ollixx77/rauch/pcb/STM32_Rauch changes.txt

circuitName   : STM32_Rauch
author        : Oliver Schumann
--------------------------------------------------------------------------------
  _ _ _   _____     ____          _ _ _ 
 | | | | |_   _|__ |  _ \  ___   | | | | ToDo
 | | | |   | |/ _ \| | | |/ _ \  | | | |
 |_|_|_|   | | (_) | |_| | (_) | |_|_|_|
 (_|_|_)   |_|\___/|____/ \___/  (_|_|_)

- ...

  _ _ _    ____ _                                   _ _ _ 
 | | | |  / ___| |__   __ _ _ __   __ _  ___  ___  | | | | Changes
 | | | | | |   | '_ \ / _` | '_ \ / _` |/ _ \/ __| | | | |
 |_|_|_| | |___| | | | (_| | | | | (_| |  __/\__ \ |_|_|_|
 (_|_|_)  \____|_| |_|\__,_|_| |_|\__, |\___||___/ (_|_|_)
                                  |___/                   

23.04.2026, STM32_Rauch_002:
Ä Relais mirrored
Ä Push button 		!RST	-> PA6
Ä TM1637 holes		2 mm	-> 3.2 mm

KW11.2026, STM32_Rauch_001:
