ollixx77/rauch/pcb/A5E52699480_001.xlsx

Bestückhilfe für Eagle |  |  |  |  |  | 1. Stückliste in Tabelle (Spalten B..G) einfügen, die Spalte "Parts" ist die wichtige
Stand | 2023-03-30 |  |  |  |  | 2. Jeweils Einträge in "C&P" kopieren und im Eagle-Layout in Befehlszeile einfügen <Enter>
 |  |  |  |  |  | 3. In Spalte "Kommentar" den Status eintragen, ok = bestückt, Probleme ect.
Qty | Value | Device | Package | Parts | Description | .. | ..2 | C&P | Kommentar
2 | 0R | R-EU_2010 | RESC2010 | R6, R9 | RESISTOR, European symbol |  |  | show @ R6 R9
2 | 0R | R-EU_0603 | RESC0603 | R12, R14 | RESISTOR, European symbol |  |  | show @ R12 R14 | ok
2 | 100R | R-EU_0603 | RESC0603 | R24, R33 | RESISTOR, European symbol |  |  | show @ R24 R33 | ok
4 | 100n | C-EU0603 | CAPC0603 | C1, C6, C8, C9 | CAPACITOR, European symbol |  |  | show @ C1 C6 C8 C9 | ok
4 | 10R | R-EU_0603 | RESC0603 | R5, R8, R11, R16 | RESISTOR, European symbol |  |  | show @ R5 R8 R11 R16 | ok
1 | 10µ/4A - IHLP2525CZER100M11 | L-EU0707 | INDM0707 | L1 | INDUCTOR, European symbol |  |  | show @ L1 | ok
1 | 150p | C-EU0603 | CAPC0603 | C7 | CAPACITOR, European symbol |  |  | show @ C7 | ok
1 | 18R | R-EU_0603 | RESC0603 | R30 | RESISTOR, European symbol |  |  | show @ R30 | ok, 25R
1 | 1M | R-EU_0603 | RESC0603 | R2 | RESISTOR, European symbol |  |  | show @ R2 | ok
6 | 1k | R-EU_0603 | RESC0603 | R4, R7, R10, R15, R22, R25 | RESISTOR, European symbol |  |  | show @ R4 R7 R10 R15 R22 R25 | ok
2 | 2,2k | R-EU_0603 | RESC0603 | R23, R32 | RESISTOR, European symbol |  |  | show @ R23 R32 | ok
1 | 22k | R-EU_0603 | RESC0603 | R1 | RESISTOR, European symbol |  |  | show @ R1 | ok
2 | 22µ/6,3V | C-EU1206 | CAPC1206 | C3, C4 | CAPACITOR, European symbol |  |  | show @ C3 C4 | ok
1 | 2k | R-EU_0603 | RESC0603 | R27 | RESISTOR, European symbol |  |  | show @ R27 | ok
6 | 33 | RRWM10X45 | RWM10X45 | R101, R102, R103, R201, R202, R203 | Power Resitor |  |  | show @ R101 R102 R103 R201 R202 R203 | FE
1 | 330p | C-EU0603 | CAPC0603 | C5 | CAPACITOR, European symbol |  |  | show @ C5 | ok, 470p
1 | 33R | R-EU_0603 | RESC0603 | R26 | RESISTOR, European symbol |  |  | show @ R26 | ok
1 | 4,7k | R-EU_0603 | RESC0603 | R3 | RESISTOR, European symbol |  |  | show @ R3 | ok
1 | 4,7µ/50V | C-EU1210 | CAPC1210 | C2 | CAPACITOR, European symbol |  |  | show @ C2 | ok
3 | 470R | R-EU_0603 | RESC0603 | R17, R18, R19 | RESISTOR, European symbol |  |  | show @ R17 R18 R19 | ok
4 | 47k | R-EU_0603 | RESC0603 | R21, R28, R34, R35 | RESISTOR, European symbol |  |  | show @ R21 R28 R34 R35 | ok
1 | 560R | R-EU_0603 | RESC0603 | R31 | RESISTOR, European symbol |  |  | show @ R31 | ok
1 | 680R | R-EU_0603 | RESC0603 | R29 | RESISTOR, European symbol |  |  | show @ R29 | ok
6 | 68n/2kV | C-EU275-205X316 | C275-205X316 | C101, C102, C103, C201, C202, C203 | CAPACITOR, European symbol |  |  | show @ C101 C102 C103 C201 C202 C203 | FE
1 | A5E52699480/RS-AA/001 | TEXT-50-TOP | DOKU-50-TOP | DOKU5 | Textfeld für Dokumentation |  |  | show @ DOKU5 | n.b.
1 | A5E________/RS-AA/001 | TEXT-30-DUMMY | DOKU-30-DUMMY | DOKU6 | Textfeld für Dokumentation |  |  | show @ DOKU6 | n.b.
1 | BAS40-05 | BAT54C | SOT23 | D5 | Dioden mit gemeinsamer Kathode |  |  | show @ D5 | ok
1 | BCX56-16 | TRANSISTOR-NPN-SOT23 | SOT23 | Q1 |  |  |  | show @ Q1 | ok, BCX-41
3 | DIODE-LED-C1608 | DIODE-LED-C1608 | LEDC1608 | D2, D3, D4 |  |  |  | show @ D2 D3 D4 | ok
1 | HEADER-M-2X05-RM254 | HEADER-M-2X05-RM254 | CON-HEADER-M-RM254-2X05 | X4 |  |  |  | show @ X4
1 | HEADER-M-2X14-RM254 | HEADER-M-2X14-RM254 | CON-HEADER-M-RM254-2X14 | X3 |  |  |  | show @ X3
1 | LM2903D | LM2903D | SOP127P600-08 | IC3 | COMPARATOR |  |  | show @ IC3 | ok, LM358
1 | LMR51430YFDDCR | LMR51430 | SOT23-6 | IC1 | LMR51430 SIMPLE SWITCHER® 4.5-V to 36-V, 3-A, Synchronous Buck Converter in a SOT-23 Package |  |  | show @ IC1 | ok
1 | MC1,5/10-G-3,81 | MC1,5/10-G-3,81 | MC1,5/10-G-3,81 | X2 | Phoenix Contact |  |  | show @ X2
4 | MOUNT-HOLE-3.2 | MOUNT-HOLE-3.2 | MOUNT-HOLE-3,2 | H1, H2, H3, H4 | Mounting Hole |  |  | show @ H1 H2 H3 H4 | ok
10 | MOUNT-PAD-ROUND1.0 | MOUNT-PAD-ROUND1.0 | 1,0-PAD | H101, H102, H103, H104, H105, H201, H202, H203, H204, H205 | MOUNTING PAD, round |  |  | show @ H101 H102 H103 H104 H105 H201 H202 H203 H204 H205 | FE
1 | MSTBVA2,5/4-G-5,08 - 1755752 | MSTBVA2,5/4-G-5,08 | MSTBVA2,5/4-G-5,08 | X1 | Phoenix Contact |  |  | show @ X1 | ok
2 | PAD-FIDU-R200 | PAD-FIDU-R200 | FIDU_RUND-2MM | DOKU1, DOKU2 | Fiducial = Passermarke |  |  | show @ DOKU1 DOKU2 | n.b.
4 | SKS01VKR | SKS01VKR | SKS01VKR | XX1, XX2, XX3, XX4 | ST50MVNR & SR50MVNR |  |  | show @ XX1 XX2 XX3 XX4
1 | SS16 | DIODE-SCHOTTKY-SMA | DIOM-SMA | D1 |  |  |  | show @ D1 | ok
1 | STM NUCLEO-G031K8 | STM32-NUCLEO32 | NUCLEO32 | M1 | Arduino Nano plug in module with SMT32 Nucleo-32 signal names |  |  | show @ M1 | n.b.
1 | STM32_oC_test_001 | TEXT-50-TOP | DOKU-50-TOP | DOKU3 | Textfeld für Dokumentation |  |  | show @ DOKU3 | n.b.
1 | TL431DBZ | TL431DBZ | SOT23 | IC2 | TL431 Precision Programmable Reference |  |  | show @ IC2 | ok
1 | close | CON-J2D | CON-SOLDERJUMPER | J1 | Jumper 2pol. |  |  | show @ J1 | ok
