ollixx77/rauch/pcb/STM32_Rauch_001.xlsx

Bestückhilfe für Eagle |  |  |  |  |  | 1. Stückliste in Tabelle (Spalten B..G) einfügen, die Spalte "Parts" ist die wichtige
Stand | 2026-03-30 |  |  |  |  | 2. Jeweils Einträge in "C&P" kopieren und im Eagle-Layout in Befehlszeile einfügen <Enter>
 |  |  |  |  |  | 3. In Spalte "Kommentar" den Status eintragen, ok = bestückt, Probleme ect.
Qty | Value | Device | Package | Parts | Description | .. | ..2 | C&P | Kommentar
11 | 100n | C-EU0603 | CAPC0603 | C2, C5, C6, C7, C8, C9, C10, C11, C12, C13, C14 | CAPACITOR, European symbol |  |  | show @ C2 C5 C6 C7 C8 C9 C10 C11 C12 C13 C14 | x
2 | 22µ/6,3V | C-EU1206 | CAPC1206 | C3, C4 | CAPACITOR, European symbol |  |  | show @ C3 C4 | x
1 | 4,7µ/50V | C-EU1210 | CAPC1210 | C1 | CAPACITOR, European symbol |  |  | show @ C1 | x
1 | open | CON-J2D | CON-SOLDERJUMPER | J1 | Jumper 2pol. |  |  | show @ J1 | n.b.
11 | LED gelb | DIODE-LED-C1608 | LEDC1608 | D4, D7, D8, D9, D10, D11, D12, D13, D14, D15, D16 |  |  |  | show @ D4 D7 D8 D9 D10 D11 D12 D13 D14 D15 D16 | x
1 | LED grün | DIODE-LED-C1608 | LEDC1608 | D6 |  |  |  | show @ D6 | x
1 | LED rot | DIODE-LED-C1608 | LEDC1608 | D5 |  |  |  | show @ D5 | x
1 | SS16 | DIODE-SCHOTTKY-SMA | DIOM-SMA | D1 |  |  |  | show @ D1 | x
1 | 1N4448 | DIODE-SOD323 | SOD323 | D3 |  |  |  | show @ D3 | x
1 | SM15T39A | DIODE-TVS-UNI-SMC | DIOM-SMC | D2 |  |  |  | show @ D2 | x
1 | 10µ/4A - IHLP2525CZER100M11 | L-EU0707 | INDM0707 | L1 | INDUCTOR, European symbol |  |  | show @ L1 | x
1 | LMR51430YFDDCR | LMR51430 | SOT23-6 | IC1 | LMR51430 SIMPLE SWITCHER® 4.5-V to 36-V, 3-A, Synchronous Buck Converter in a SOT-23 Package |  |  | show @ IC1 | x
1 | MCV1,5/10-G-3,81 | MCV1,5/10-G-3,81 | MCV1,5/10-G-3,81 | X4 | Phoenix Contact |  |  | show @ X4 | x
1 | MCV1,5/4-G-3,81 | MCV1,5/4-G-3,81 | MCV1,5/4-G-3,81 | X3 | Phoenix Contact |  |  | show @ X3 | x
1 | MOLEX-6410/4 | MOLEX-6410/4 | MOLEX-6410/4 | X5 | Molex Serie 6410 |  |  | show @ X5 | falsches Raster
4 | MOUNT-HOLE-3.2 | MOUNT-HOLE-3.2 | MOUNT-HOLE-3,2 | H1, H2, H3, H4 | Mounting Hole |  |  | show @ H1 H2 H3 H4 | zu klein
1 | MSTBVA2,5/3-G-5,08 | MSTBVA2,5/3-G-5,08 | MSTBVA2,5/3-G-5,08 | X2 | Phoenix Contact |  |  | show @ X2 | x
1 | MSTBVA2,5/4-G-5,08 - 1755752 | MSTBVA2,5/4-G-5,08 | MSTBVA2,5/4-G-5,08 | X1 | Phoenix Contact |  |  | show @ X1 | x
1 | G5Q-14-EU DC12 (TY) | RELAIS1-OMRON-G5Q | OMRON-G5Q | K1 |  |  |  | show @ K1 | falsch herum
10 | 10K | R-EU_0603 | RESC0603 | R11, R12, R13, R14, R15, R26, R27, R28, R29, R30 | RESISTOR, European symbol |  |  | show @ R11 R12 R13 R14 R15 R26 R27 R28 R29 R30 | x
1 | 1k | R-EU_0603 | RESC0603 | R7 | RESISTOR, European symbol |  |  | show @ R7 | x
1 | 1M | R-EU_0603 | RESC0603 | R2 | RESISTOR, European symbol |  |  | show @ R2 | x
1 | 36k | R-EU_0603 | RESC0603 | R1 | RESISTOR, European symbol |  |  | show @ R1 | x
1 | 4,7k | R-EU_0603 | RESC0603 | R3 | RESISTOR, European symbol |  |  | show @ R3 | x
10 | 4.7k | R-EU_0603 | RESC0603 | R31, R32, R33, R34, R35, R36, R37, R38, R39, R40 | RESISTOR, European symbol |  |  | show @ R31 R32 R33 R34 R35 R36 R37 R38 R39 R40 | x
4 | 470R | R-EU_0603 | RESC0603 | R4, R8, R9, R10 | RESISTOR, European symbol |  |  | show @ R4 R8 R9 R10 | x
10 | 68k | R-EU_0603 | RESC0603 | R16, R17, R18, R19, R20, R21, R22, R23, R24, R25 | RESISTOR, European symbol |  |  | show @ R16 R17 R18 R19 R20 R21 R22 R23 R24 R25 | x
2 | n.b. | R-EU_0603 | RESC0603 | R5, R6 | RESISTOR, European symbol |  |  | show @ R5 R6 | n.b.
1 | SCHURTER_LSH | SCHURTER_LSH | SHURTER_LSH | S1 |  |  |  | show @ S1 | x
1 | STM NUCLEO-G031K8 | STM32-NUCLEO32 | NUCLEO32 | M1 | Arduino Nano plug in module with SMT32 Nucleo-32 signal names |  |  | show @ M1 | x
1 | TM1637 | TM1637 | TM1637 | DIS1 | TM1637 |  |  | show @ DIS1 | redesign
11 | BC547 | TRANSISTOR-NPN-SOT23 | SOT23 | Q1, Q2, Q3, Q4, Q5, Q6, Q7, Q8, Q9, Q10, Q11 |  |  |  | show @ Q1 Q2 Q3 Q4 Q5 Q6 Q7 Q8 Q9 Q10 Q11 | BC847B
