ollixx77/rauch/pcb/STM32_Rauch_002.pdf

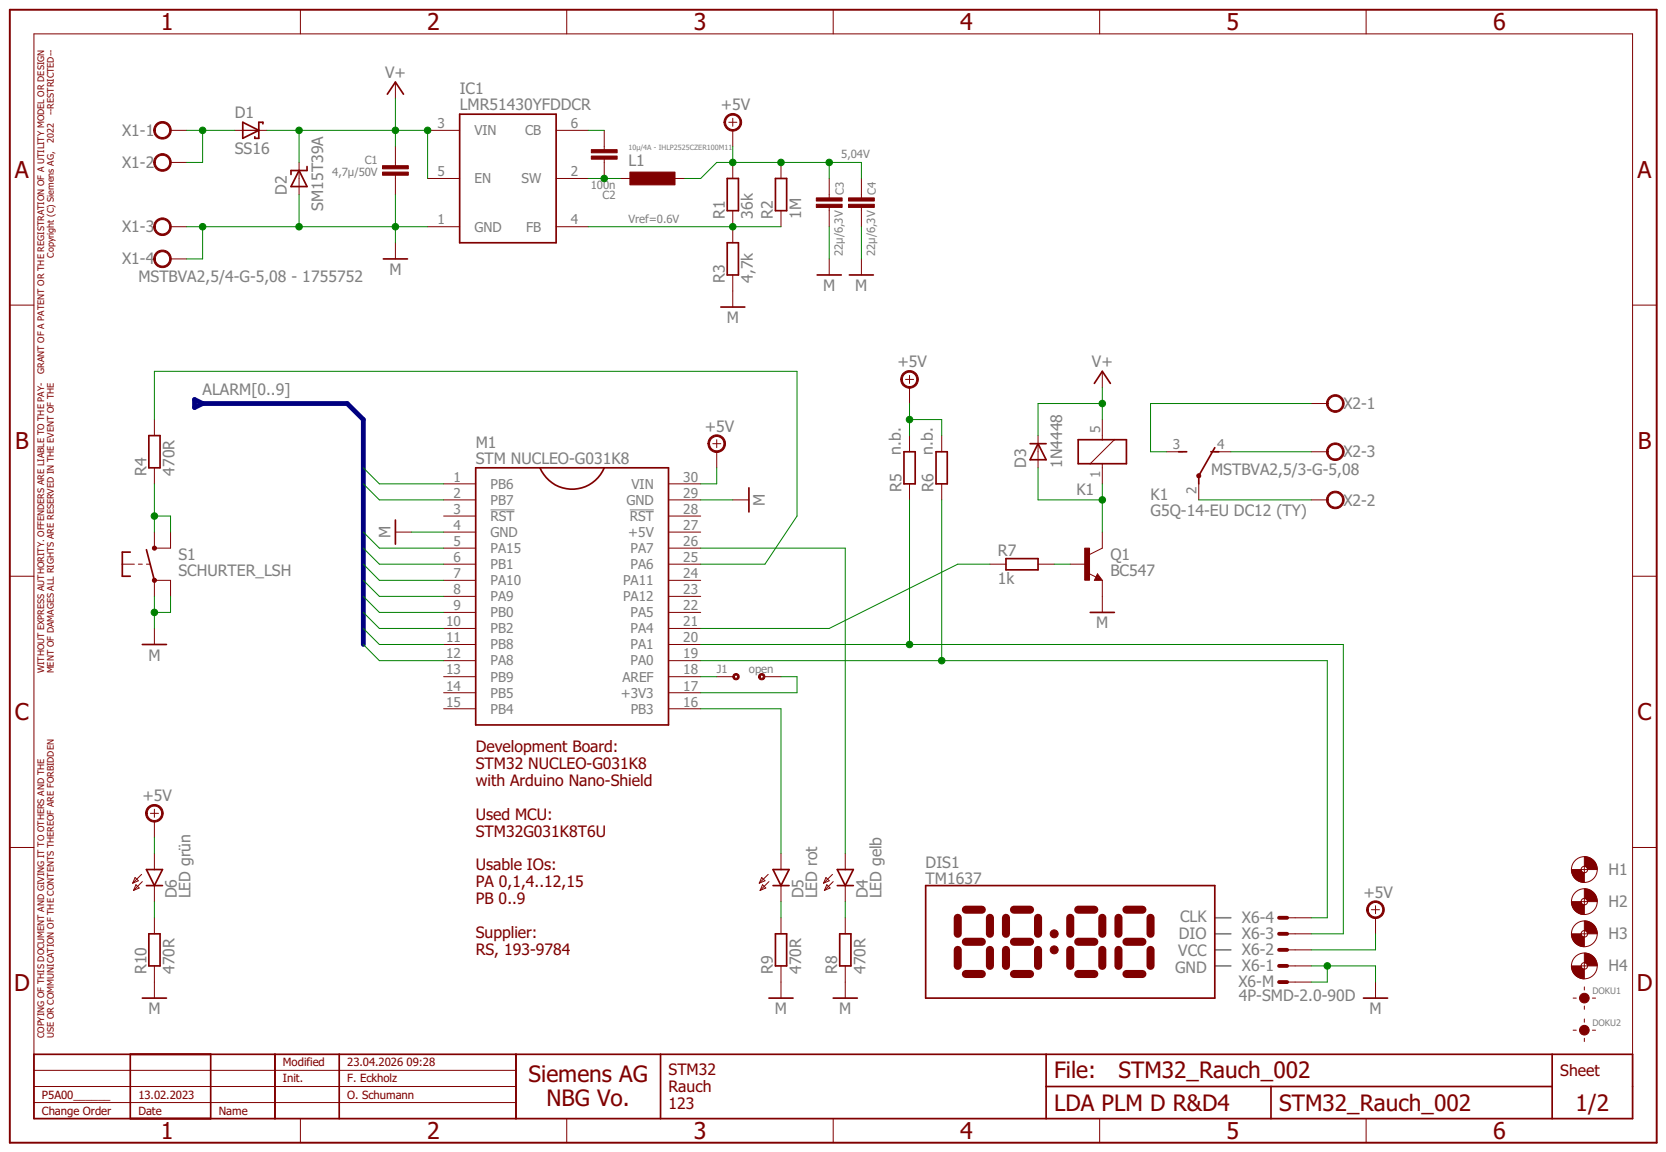
[picture p1: page 1]

COPYING OF THIS DOCUMENT AND GIVING IT TO OTHERS AND THE USE OR COMMUNICATION OF THE CONTENTS THEREOF ARE FORBIDDEN WITHOUT EXPRESS AUTHORITY. OFFENDERS ARE LIABLE TO THE PAY- MENT OF DAMAGES ALL RIGHTS ARE RESERVED IN THE EVENT OF THE GRANT OF A PATENT OR THE REGISTRATION OF A UTILITY MODEL OR DESIGN

Copyright (C) Siemens AG, 2022 --RESTRICTED--

19 PA1
17 AREF 18 PA0 J1 open | TM1637

Development Board: STM32 NUCLEO-G031K8 with Arduino Nano-Shield

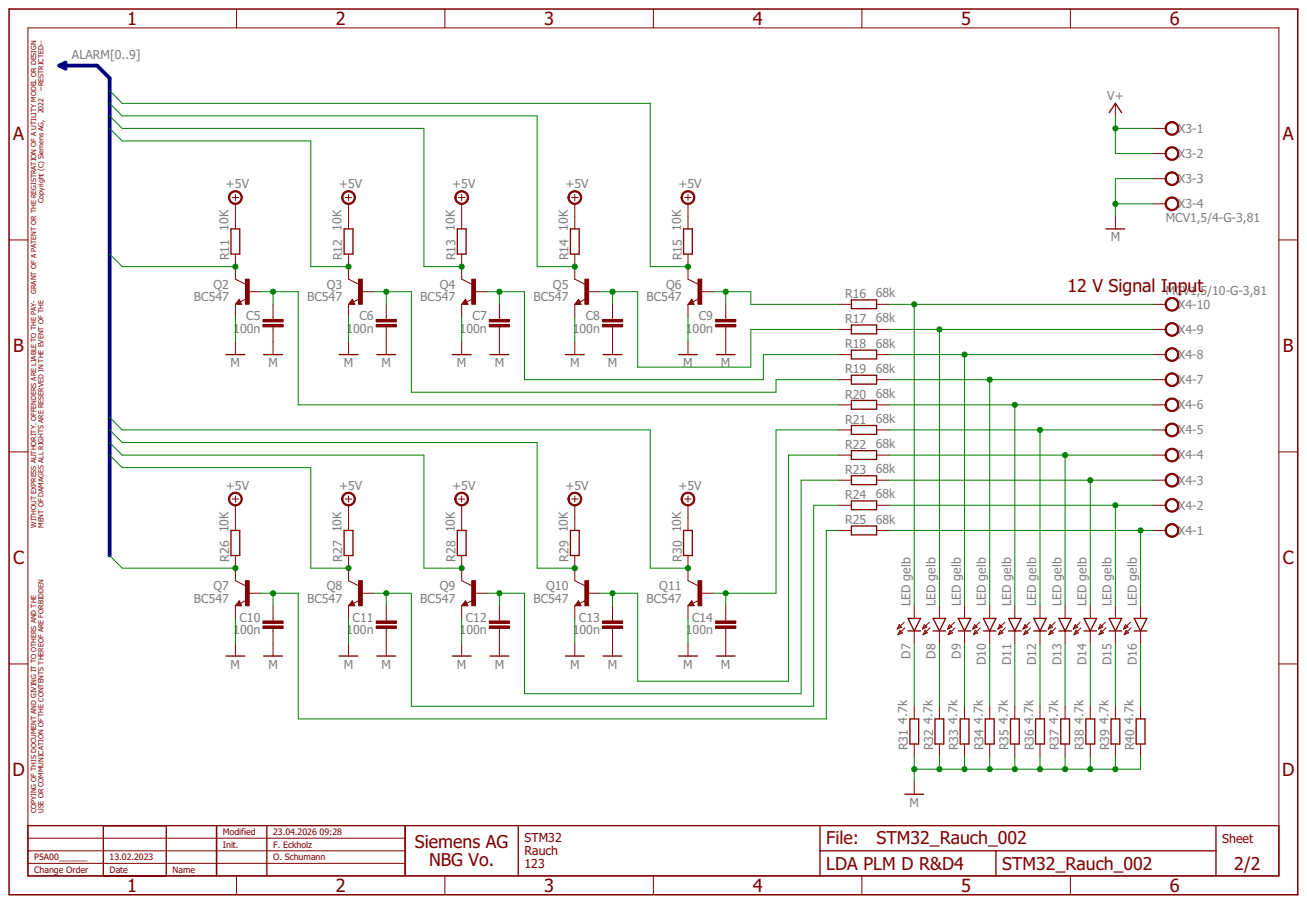
[picture p2: page 2]
