ollixx77/rauch/Doku/TM1637 eagle files/Grove  4-Digit Display V1.0_pcb.pdf

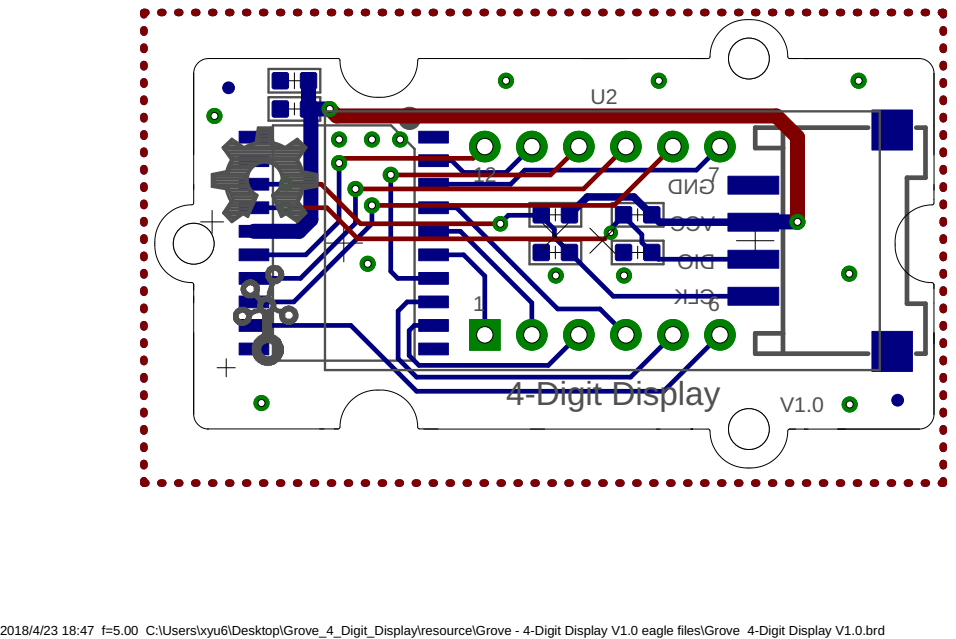
[picture p3: page 1]

2018/4/23 18:47 f=5.00 C:\Users\xyu6\Desktop\Grove_4_Digit_Display\resource\Grove - 4-Digit Display V1.0 eagle files\Grove 4-Digit Display V1.0.brd
