ollixx77/rauch/Doku/TM1637 eagle files/Grove  4-Digit Display V1.0_sch.pdf

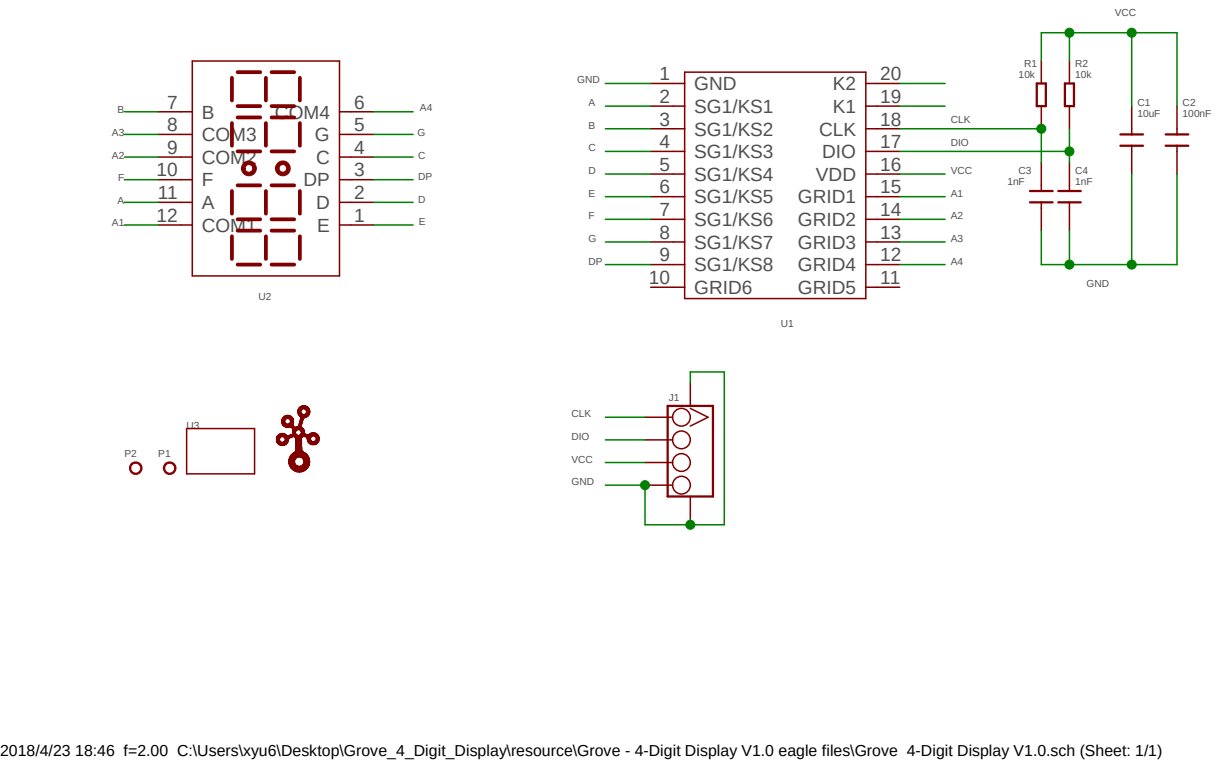
[picture p4: page 1]

2018/4/23 18:46 f=2.00 C:\Users\xyu6\Desktop\Grove_4_Digit_Display\resource\Grove - 4-Digit Display V1.0 eagle files\Grove 4-Digit Display V1.0.sch (Sheet: 1/1)
