ollixx77/rauch/pcb/STM32_Rauch_002.brd

## EAGLE design pcb/STM32_Rauch_002.brd (2026-04-24)

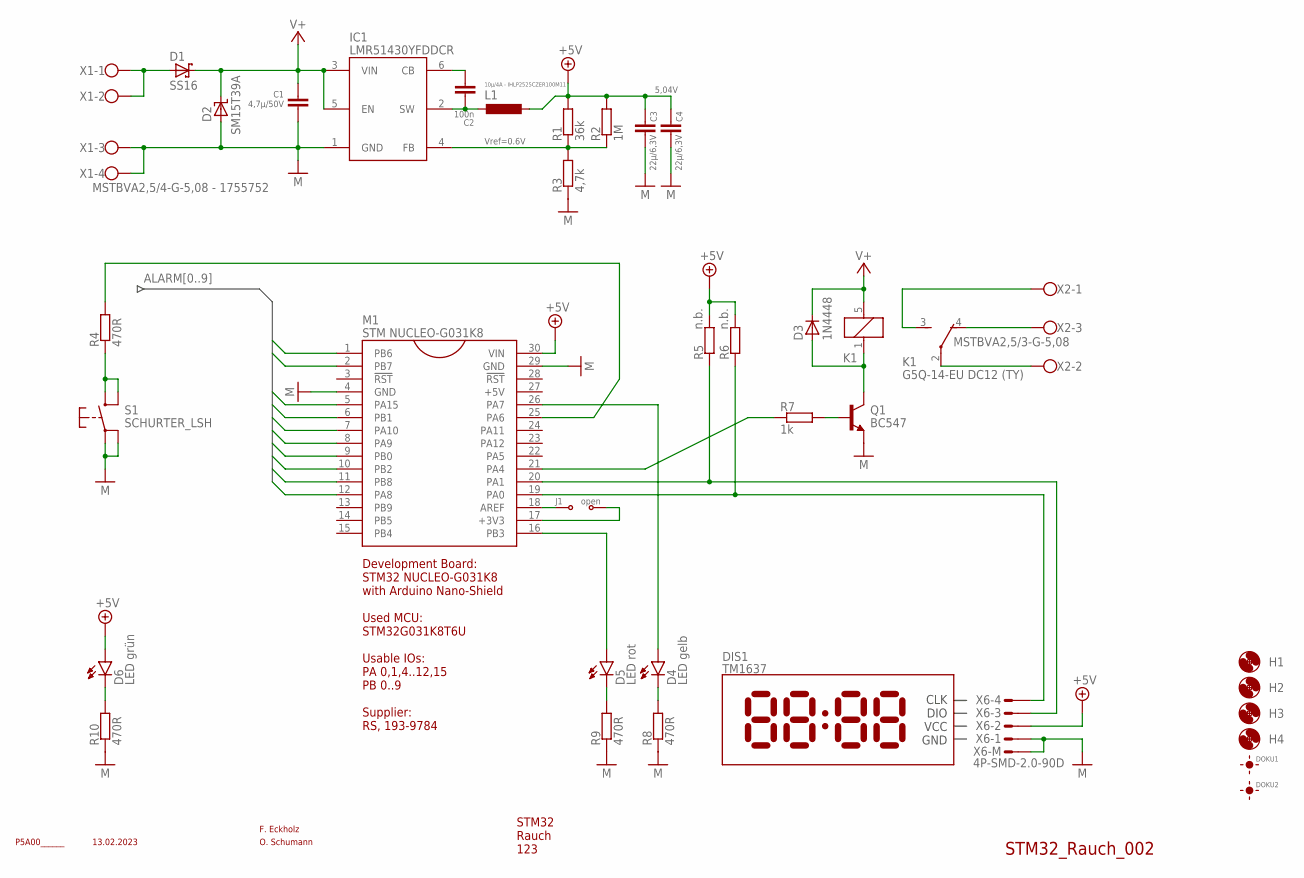
[picture p5: schematic STM32_Rauch_002.sch, sheet 1]

Parts:
C1: 4,7µ/50V; CAPC1210
C2: 100n; CAPC0603
C3, C4: 22µ/6,3V; CAPC1206
D1: SS16; DIOM-SMA
D2: SM15T39A; DIOM-SMC
D3: 1N4448; SOD323
D4: LED gelb; LEDC1608
D5: LED rot; LEDC1608
D6: LED grün; LEDC1608
DIS1: TM1637
DOKU1, DOKU2: PAD-FIDU-R200; FIDU_RUND-2MM
DOKU4: STM32_Rauch_002; DOKU-50-TOP
H1, H2, H3, H4: MOUNT-HOLE-3.2; MOUNT-HOLE-3,2
IC1: LMR51430YFDDCR; SOT23-6
J1: open; CON-SOLDERJUMPER
K1: G5Q-14-EU DC12 (TY); OMRON-G5Q
L1: 10µ/4A - IHLP2525CZER100M11; INDM0707
M1: STM NUCLEO-G031K8; NUCLEO32
Q1: BC547; SOT23
R1: 36k; RESC0603
R2: 1M; RESC0603
R3: 4,7k; RESC0603
R4, R8, R9, R10: 470R; RESC0603
R5, R6: n.b.; RESC0603
R7: 1k; RESC0603
S1: SCHURTER_LSH; SHURTER_LSH
X1: MSTBVA2,5/4-G-5,08 - 1755752; MSTBVA2,5/4-G-5,08
X2: MSTBVA2,5/3-G-5,08
X6: 4P-SMD-2.0-90D

Connections:
!RESET: M1.25 (PA6), R4.2
+5V: C3.2, C4.2, D6.2 (A), L1.2, M1.30 (VIN), R1.2, R2.2, R5.2, R6.2, X6.2; also elsewhere on the board
ALARM0: M1.1 (PB6); also elsewhere on the board
ALARM1: M1.2 (PB7); also elsewhere on the board
ALARM2: M1.5 (PA15); also elsewhere on the board
ALARM3: M1.6 (PB1); also elsewhere on the board
ALARM4: M1.7 (PA10); also elsewhere on the board
ALARM5: M1.8 (PA9); also elsewhere on the board
ALARM6: M1.9 (PB0); also elsewhere on the board
ALARM7: M1.10 (PB2); also elsewhere on the board
ALARM8: M1.11 (PB8); also elsewhere on the board
ALARM9: M1.12 (PA8); also elsewhere on the board
M: C1.1, C3.1, C4.1, D2.2 (A), IC1.1 (GND), M1.4 (GND), M1.29 (GND), Q1.2 (E), R3.1, R8.1, R9.1, R10.1, S1.1, S1.2, X1.3, X1.4, X6.1, X6.SS1, X6.SS2; also elsewhere on the board
unnamed: D3.A, K1.1 (COIL1), Q1.3 (C)
unnamed: D1.2 (A), X1.1, X1.2
unnamed: R4.1, S1.3 (S), S1.4 (S)
unnamed: D4.1 (C), R8.2
unnamed: Q1.1 (B), R7.2
unnamed: D5.1 (C), R9.2
unnamed: M1.21 (PA4), R7.1
unnamed: C2.1, IC1.6 (CB)
unnamed: C2.2, IC1.2 (SW), L1.1
unnamed: IC1.4 (FB), R1.1, R2.1, R3.2
unnamed: K1.2 (C), X2.2
unnamed: K1.3 (NO), X2.1
unnamed: K1.4 (NC), X2.3
unnamed: M1.19 (PA0), R6.1, X6.4
unnamed: D6.1 (C), R10.2
unnamed: J1.1, M1.18 (AREF)
unnamed: M1.20 (PA1), R5.1, X6.3
unnamed: D4.2 (A), M1.26 (PA7)
unnamed: D5.2 (A), M1.16 (PB3)
unnamed: J1.2, M1.17 (+3V3)
V+: C1.2, D1.1 (K), D2.1 (C), D3.C, IC1.3 (VIN), IC1.5 (EN), K1.5 (COIL2); also elsewhere on the board

Notes on the sheet:
O. Schumann
F. Eckholz
STM32 Rauch 123
P5A00______
13.02.2023
5,04V
Vref=0.6V
Development Board: STM32 NUCLEO-G031K8 with Arduino Nano-Shield Used MCU: STM32G031K8T6U Usable IOs: PA 0,1,4..12,15 PB 0..9 Supplier: RS, 193-9784

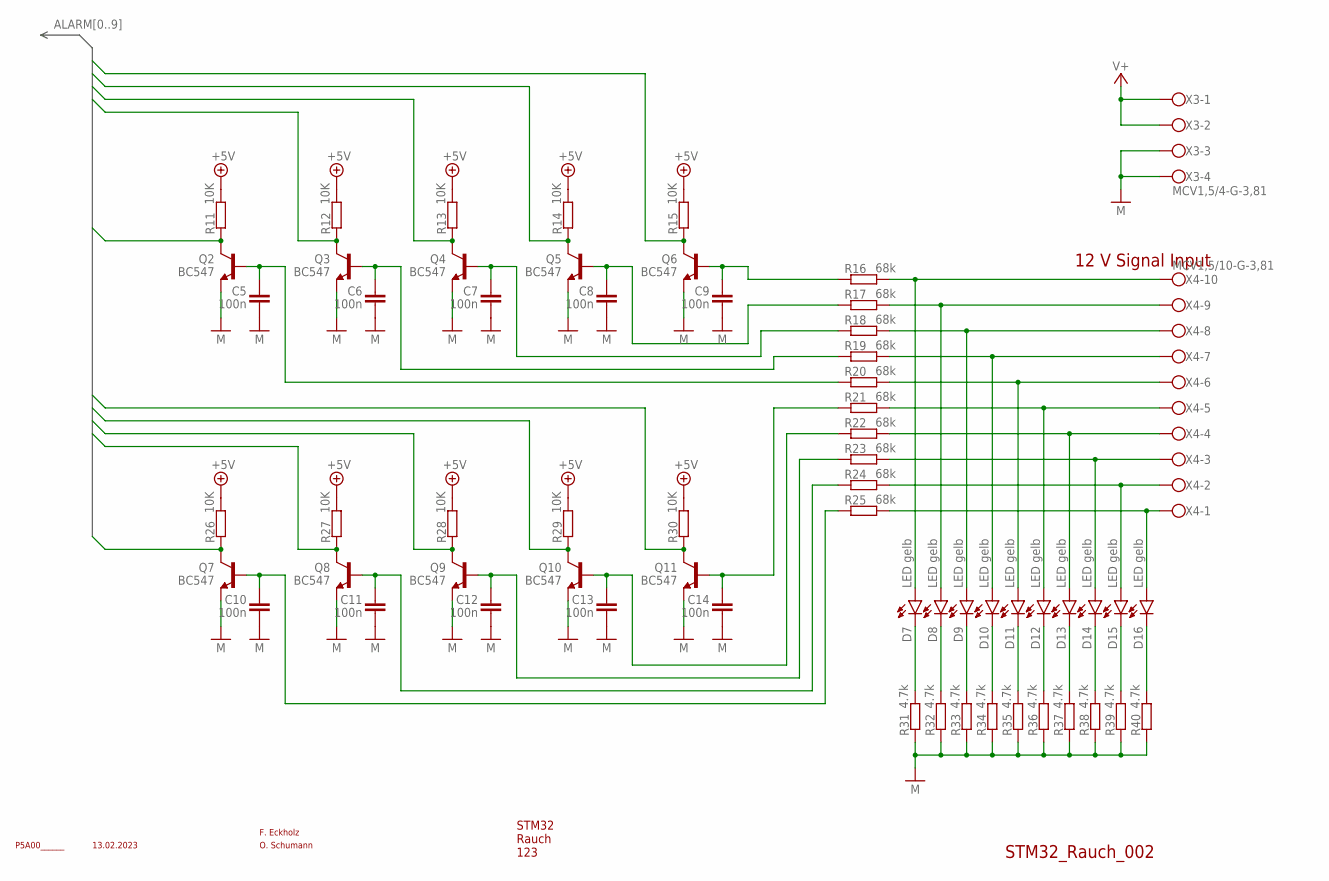
[picture p6: schematic STM32_Rauch_002.sch, sheet 2]

Parts:
C5, C6, C7, C8, C9, C10, C11, C12, C13, C14: 100n; CAPC0603
D7, D8, D9, D10, D11, D12, D13, D14, D15, D16: LED gelb; LEDC1608
DOKU4: STM32_Rauch_002; DOKU-50-TOP
Q2, Q3, Q4, Q5, Q6, Q7, Q8, Q9, Q10, Q11: BC547; SOT23
R11, R12, R13, R14, R15, R26, R27, R28, R29, R30: 10K; RESC0603
R16, R17, R18, R19, R20, R21, R22, R23, R24, R25: 68k; RESC0603
R31, R32, R33, R34, R35, R36, R37, R38, R39, R40: 4.7k; RESC0603
X3: MCV1,5/4-G-3,81
X4: MCV1,5/10-G-3,81

Connections:
+5V: R11.2, R12.2, R13.2, R14.2, R15.2, R26.2, R27.2, R28.2, R29.2, R30.2; also elsewhere on the board
ALARM0: Q6.3 (C), R15.1; also elsewhere on the board
ALARM1: Q5.3 (C), R14.1; also elsewhere on the board
ALARM2: Q4.3 (C), R13.1; also elsewhere on the board
ALARM3: Q3.3 (C), R12.1; also elsewhere on the board
ALARM4: Q2.3 (C), R11.1; also elsewhere on the board
ALARM5: Q11.3 (C), R30.1; also elsewhere on the board
ALARM6: Q10.3 (C), R29.1; also elsewhere on the board
ALARM7: Q9.3 (C), R28.1; also elsewhere on the board
ALARM8: Q8.3 (C), R27.1; also elsewhere on the board
ALARM9: Q7.3 (C), R26.1; also elsewhere on the board
M: C5.1, C6.1, C7.1, C8.1, C9.1, C10.1, C11.1, C12.1, C13.1, C14.1, Q2.2 (E), Q3.2 (E), Q4.2 (E), Q5.2 (E), Q6.2 (E), Q7.2 (E), Q8.2 (E), Q9.2 (E), Q10.2 (E), Q11.2 (E), R31.1, R32.1, R33.1, R34.1, R35.1, R36.1, R37.1, R38.1, R39.1, R40.1, X3.P$3, X3.P$4; also elsewhere on the board
unnamed: D7.2 (A), R16.2, X4.P$10
unnamed: D7.1 (C), R31.2
unnamed: C14.2, Q11.1 (B), R21.1
unnamed: D14.2 (A), R23.2, X4.P$3
unnamed: C13.2, Q10.1 (B), R22.1
unnamed: D8.2 (A), R17.2, X4.P$9
unnamed: D9.2 (A), R18.2, X4.P$8
unnamed: D10.2 (A), R19.2, X4.P$7
unnamed: D11.2 (A), R20.2, X4.P$6
unnamed: D12.2 (A), R21.2, X4.P$5
unnamed: D13.2 (A), R22.2, X4.P$4
unnamed: D15.2 (A), R24.2, X4.P$2
unnamed: D16.2 (A), R25.2, X4.P$1
unnamed: D8.1 (C), R32.2
unnamed: D9.1 (C), R33.2
unnamed: D10.1 (C), R34.2
unnamed: D11.1 (C), R35.2
unnamed: D12.1 (C), R36.2
unnamed: D13.1 (C), R37.2
unnamed: C12.2, Q9.1 (B), R23.1
unnamed: D14.1 (C), R38.2
unnamed: D15.1 (C), R39.2
unnamed: C11.2, Q8.1 (B), R24.1
unnamed: D16.1 (C), R40.2
unnamed: C9.2, Q6.1 (B), R16.1
unnamed: C8.2, Q5.1 (B), R17.1
unnamed: C7.2, Q4.1 (B), R18.1
unnamed: C6.2, Q3.1 (B), R19.1
unnamed: C10.2, Q7.1 (B), R25.1
unnamed: C5.2, Q2.1 (B), R20.1
V+: X3.P$1, X3.P$2; also elsewhere on the board

Notes on the sheet:
O. Schumann
F. Eckholz
STM32 Rauch 123
P5A00______
13.02.2023
12 V Signal Input

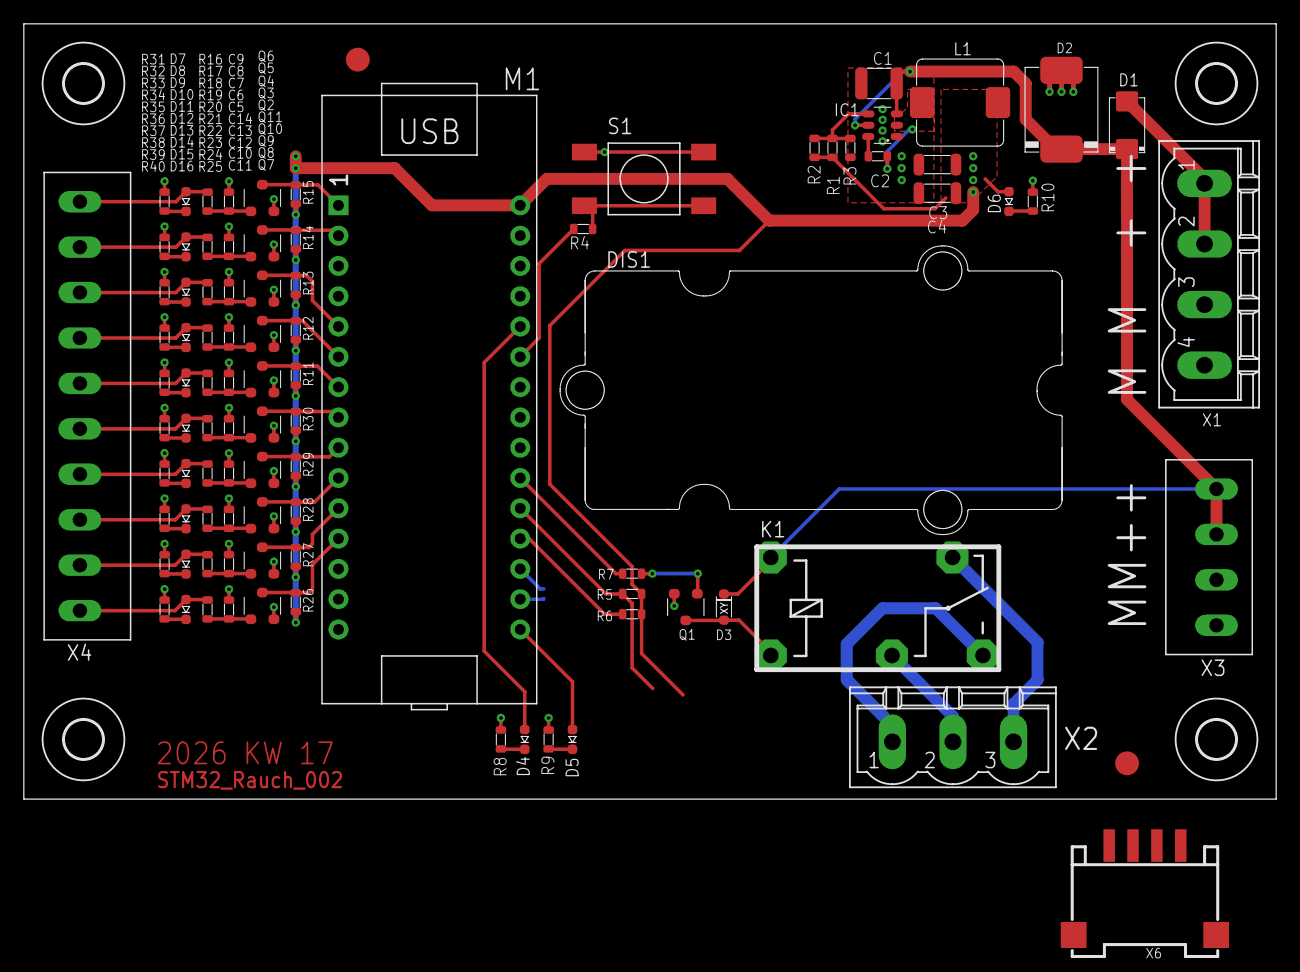
[picture p7: board STM32_Rauch_002.brd from above]

Board: 2 copper layers, 105.0 x 65.0 mm, 100 parts (1 on the bottom side), 64 nets.
