ollixx77/rauch/pcb/STM32_Rauch_002.brd

## EAGLE design Doku/TM1637 eagle files/Grove 4-Digit Display V1.0.brd

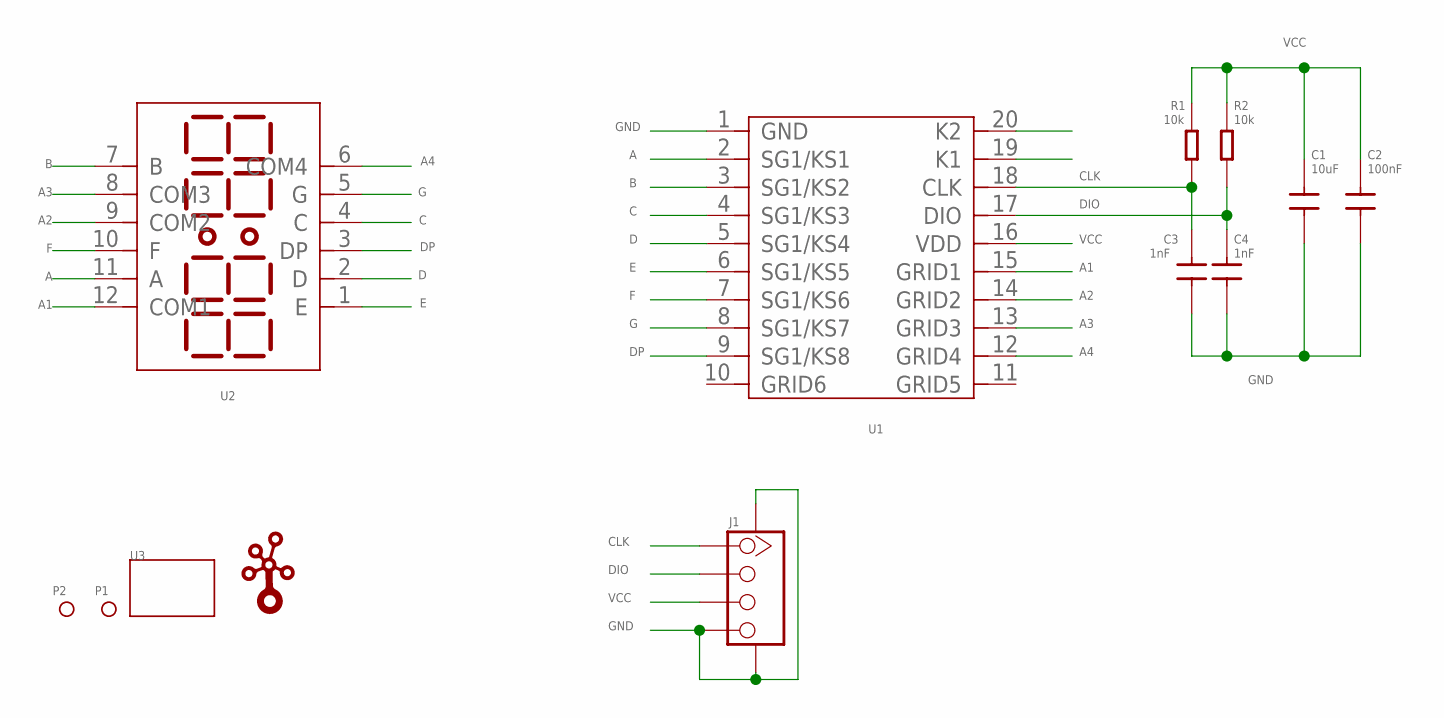
[picture p8: schematic Grove 4-Digit Display V1.0.sch]

Parts:
C1: 10uF; 0603
C2: 100nF; 0603
C3, C4: 1nF; 0603
J1: TWIG-4P-2.0-SMD-FEMALE-REINFORCE'90D'; 4P-SMD-2.0-90D
P1, P2: PAD-MARK; ROUND-MARK-0.635
R1, R2: 10k; 0603
U1: TM1637; SOP20-10.45
U2: LED-4-BETY-7-SEG; 7-4-BYTE-SEG-2.54-30X14X7.3H
U3: TWIG-2U; 2U-DIM-W/-DRILL
U$1: LOGO-TWIGTWIGLOGO_SMALL; TWIGLOGO_SMALL

Connections:
A: U1.2 (SG1/KS1), U2.11 (A)
A1: U1.15 (GRID1), U2.12 (COM1)
A2: U1.14 (GRID2), U2.9 (COM2)
A3: U1.13 (GRID3), U2.8 (COM3)
A4: U1.12 (GRID4), U2.6 (COM4)
B: U1.3 (SG1/KS2), U2.7 (B)
C: U1.4 (SG1/KS3), U2.4 (C)
CLK: C3.1, J1.1, R1.2, U1.18 (CLK)
D: U1.5 (SG1/KS4), U2.2 (D)
DIO: C4.1, J1.2, R2.2, U1.17 (DIO)
DP: U1.9 (SG1/KS8), U2.3 (DP)
E: U1.6 (SG1/KS5), U2.1 (E)
F: U1.7 (SG1/KS6), U2.10 (F)
G: U1.8 (SG1/KS7), U2.5 (G)
GND: C1.2, C2.2, C3.2, C4.2, J1.4, J1.SS1, J1.SS2, U1.1 (GND)
VCC: C1.1, C2.1, J1.3, R1.1, R2.1, U1.16 (VDD)

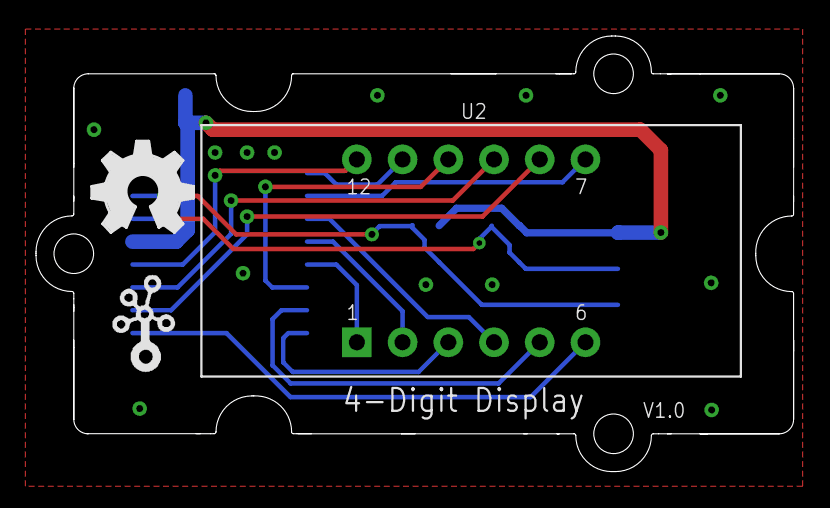
[picture p9: board Grove 4-Digit Display V1.0.brd from above]

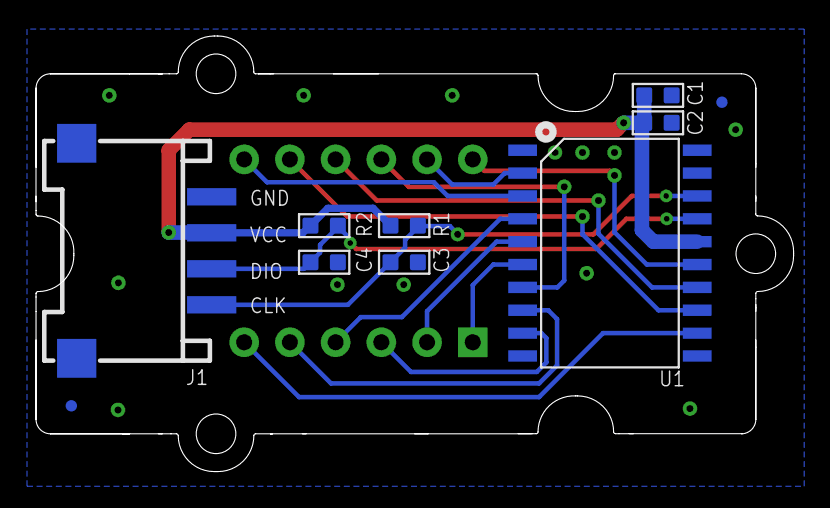
[picture p10: board Grove 4-Digit Display V1.0.brd from below]

Board: 2 copper layers, 42.1 x 24.2 mm, 14 parts (10 on the bottom side), 16 nets.

Other parts of the board:
U$12: OSHW_FILLX200_NOTEXT
