ollixx77/rauch/rauch.ioc

Mcu.UserName=STM32G031K8Tx
PA0.Signal=GPIO_Output
PA1.Signal=GPIO_Output
PA10.Signal=GPIO_Input
PA13.GPIO_Label=T_JTMS
PA13.Signal=SYS_SWDIO
PA14-BOOT0.GPIO_Label=T_JTCK
PA14-BOOT0.Signal=SYS_SWCLK
PA15.Signal=GPIO_Input
PA2.GPIO_Label=T_VCP_TX
PA2.Signal=USART2_TX
PA3.GPIO_Label=T_VCP_RX
PA3.Signal=USART2_RX
PA4.Signal=GPIO_Output
PA6.Signal=GPIO_Input
PA7.Signal=GPIO_Output
PA8.Signal=GPIO_Input
PA9.Signal=GPIO_Input
PB0.Signal=GPIO_Input
PB1.Signal=GPIO_Input
PB2.Signal=GPIO_Input
PB3.Signal=GPIO_Output
PB6.Signal=GPIO_Input
PB7.Signal=GPIO_Input
PB8.Signal=GPIO_Input
PC6.GPIO_Label=LD3 [Green]
PC6.Signal=GPIO_Output
