ollixx77/rauch/(commit log)

2026-04-24 Update .gitignore for STM32 and debug files
    Added entries for STM32 development and various debug and output files to .gitignore.
2026-04-24 Doku & PCB files
    [A5E52699480_001.xlsx, Grove 4-Digit Display V1.0.brd, Grove 4-Digit Display V1.0.sch, STM32_Rauch_001.brd, STM32_Rauch_001.csv, STM32_Rauch_001.sch, STM32_Rauch_001.xlsx, STM32_Rauch_002.brd]
2026-04-25 corrected tm1637 7-segment mapping for chars ^_[]
    [app.c, tm1637.c]
